akulavolk/AudioProcessor/README.md

Volume/tone control board based on the TDA7439 audio processor chip and [ahuxtable's Arduino library](https://github.com/ahuxtable/TDA7439).
