akulavolk/AudioProcessor/board/BOM.xlsx

Table 1
Qty | Value | Device | Package | Parts | Description | MPN | Notes
1 |  | DIODE-DO214AC | DO-214AC | D2 |  | MF-DIO-SMA-B140
2 | 0.1uF | CAPACITOR-0603 | CAPACITOR-0603 | C1, C5 | Ceramic Capacitor | MF-CAP-0603-0.1uF
2 | 0.47uF | CAPACITOR-5MM | CAPACITOR-5MM | C4, C7 | Film Capacitor | B32529C474J | This should be B32529C0474J289 but this is what returns an available result in MacroFab’s search
1 | 100K | RESISTOR-0805 | RESISTOR-0805 | R8 |  | MF-RES-0805-100K
4 | 100nF | CAPACITOR-5MM | CAPACITOR-5MM | C13, C14, C15, C16 | Film Capacitor | B32529C0104J289 | This should be B32529C0104J289 but we use the mangled part number so Macrofab can find the one we want
3 | 10K | RESISTOR-0805 | RESISTOR-0805 | R3, R4, R5 |  | MF-RES-0805-10K
3 | 10uF | CAPACITOR-1206 | CAPACITOR-1206 | C2, C3, C6 | Ceramic Capacitor | MF-CAP-1206-10uF
2 | 18nF | CAPACITOR-5MM | CAPACITOR-5MM | C11, C18 | Film Capacitor | B32529C0183J289 | Suffix 000 is bulk packaging
2 | 2.7K | RESISTOR-0805 | RESISTOR-0805 | R10, R11 |  | RC0805FR-072K7L
2 | 22nF | CAPACITOR-5MM | CAPACITOR-5MM | C12, C17 | Film Capacitor | B32529C0223J289 | Suffix 000 is bulk packaging
3 | 470 | RESISTOR-0805 | RESISTOR-0805 | R1, R2, R6 |  | MF-RES-0805-470
1 | 470uF | CAPACITOR-POLARIZED-3.5-8 | CAP-POL-3.5-8 | C9 | Polarized Capacitor | 16YXJ470M8X11.5
2 | 5.6K | RESISTOR-0805 | RESISTOR-0805 | R9, R12 |  | MF-RES-0805-5.6K
2 | 5.6nF | CAPACITOR-5MM | CAPACITOR-5MM | C8, C10 | Film Capacitor | B32529C0562J289 | Suffix 000 is bulk packaging
1 | 680K | RESISTOR-0805 | RESISTOR-0805 | R7 |  | MF-RES-0805-680K
1 | ATTINY24/44/84-SSU | ATTINY24/44/84-SSU | SO-14 | IC1 | 8-bit Microcontroller with In-System Programmable Flash | ATTINY84A-SSU
1 | ICSP-HEADER-6 | ICSP-HEADER-6 | ICSP-HEADER | ISP1 | ICSP HEADER
1 | LED-0805 | LED-0805 | LED-0805 | D1 |  | MF-LED-0805-RED
2 | LP2951 | LP2951 | SOIC-08 | IC2, IC3 |  | LP2951-33DR
4 | PINHD-1X3-JST-PH | PINHD-1X3-JST-PH | JST-B3B-PH | J1, J2, J3, J4 | PIN HEADER | B3B-PH-K-S(LF)(SN)
1 | PINHD-1X2-JST-PH | PINHD-1X2-JST-PH | JST-B3B-PH | J5 | PIN HEADER | B2B-PH-K-S(LF)(SN)
1 | PINHD-1X6-JST-PH | PINHD-1X6-JST-PH | JST-B6B-PH | J6 |  | B6B-PH-K-S(LF)(SN)
1 | TDA7439DS | TDA7439DS | SO-28W | IC4 |  | TDA7439DS13TR
