akulavolk/AudioProcessor/board/AudioProcessor.brd

## EAGLE design board/AudioProcessor.brd (2018-02-14)

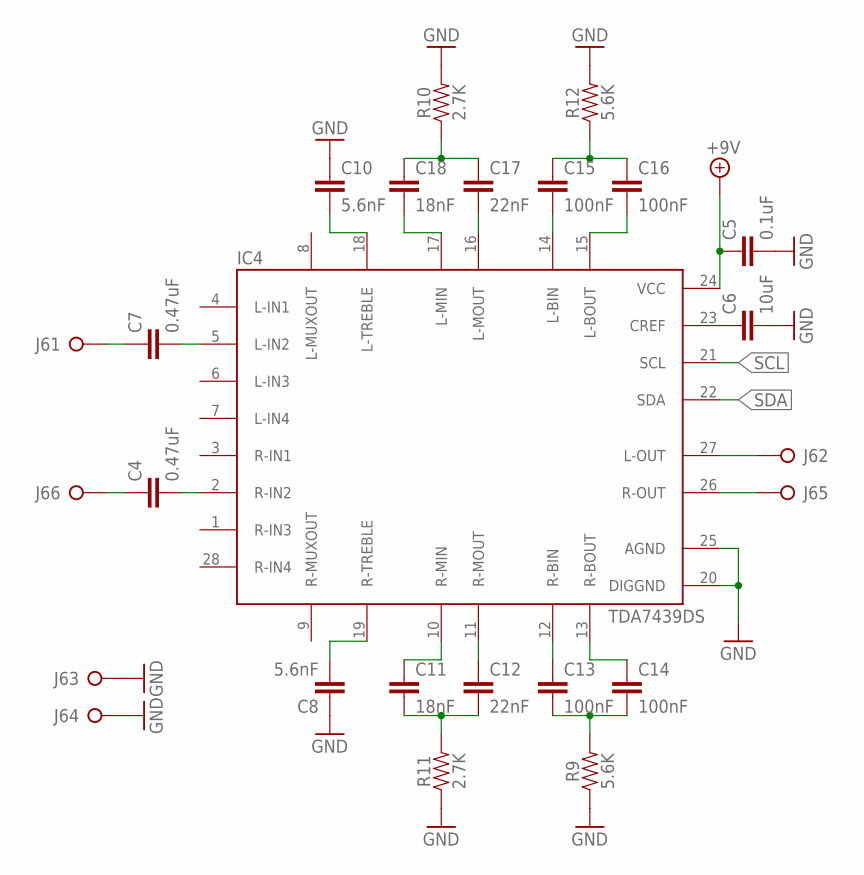
[picture p1: schematic AudioProcessor.sch, sheet 1]

Parts:
C4, C7: 0.47uF; CAPACITOR-5MM
C5: 0.1uF; CAPACITOR-0603
C6: 10uF; CAPACITOR-1206
C8, C10: 5.6nF; CAPACITOR-5MM
C11, C18: 18nF; CAPACITOR-5MM
C12, C17: 22nF; CAPACITOR-5MM
C13, C14, C15, C16: 100nF; CAPACITOR-5MM
IC4: TDA7439DS; SO-28W
J6: PINHD-1X6-JST-PH; JST-B6B-PH
R9, R12: 5.6K; RESISTOR-0805
R10, R11: 2.7K; RESISTOR-0805

Connections:
+9V: C5.1, IC4.24 (VCC); also elsewhere on the board
GND: C5.2, C6.2, C8.1, C10.1, IC4.20 (DIGGND), IC4.25 (AGND), J6.3, J6.4, R9.1, R10.2, R11.1, R12.2; also elsewhere on the board
L-IN: C7.2, IC4.5 (L-IN2)
L-IN-RAW: C7.1, J6.1
L-OUT: IC4.27 (L-OUT), J6.2
unnamed: C10.2, IC4.18 (L-TREBLE)
unnamed: C18.2, IC4.17 (L-MIN)
unnamed: C17.2, IC4.16 (L-MOUT)
unnamed: C17.1, C18.1, R10.1
unnamed: C15.2, IC4.14 (L-BIN)
unnamed: C16.2, IC4.15 (L-BOUT)
unnamed: C15.1, C16.1, R12.1
unnamed: C8.2, IC4.19 (R-TREBLE)
unnamed: C11.1, IC4.10 (R-MIN)
unnamed: C12.1, IC4.11 (R-MOUT)
unnamed: C11.2, C12.2, R11.2
unnamed: C13.2, C14.2, R9.2
unnamed: C14.1, IC4.13 (R-BOUT)
unnamed: C13.1, IC4.12 (R-BIN)
unnamed: C6.1, IC4.23 (CREF)
R-IN: C4.2, IC4.2 (R-IN2)
R-IN-RAW: C4.1, J6.6
R-OUT: IC4.26 (R-OUT), J6.5
SCL: IC4.21 (SCL); also elsewhere on the board
SDA: IC4.22 (SDA); also elsewhere on the board

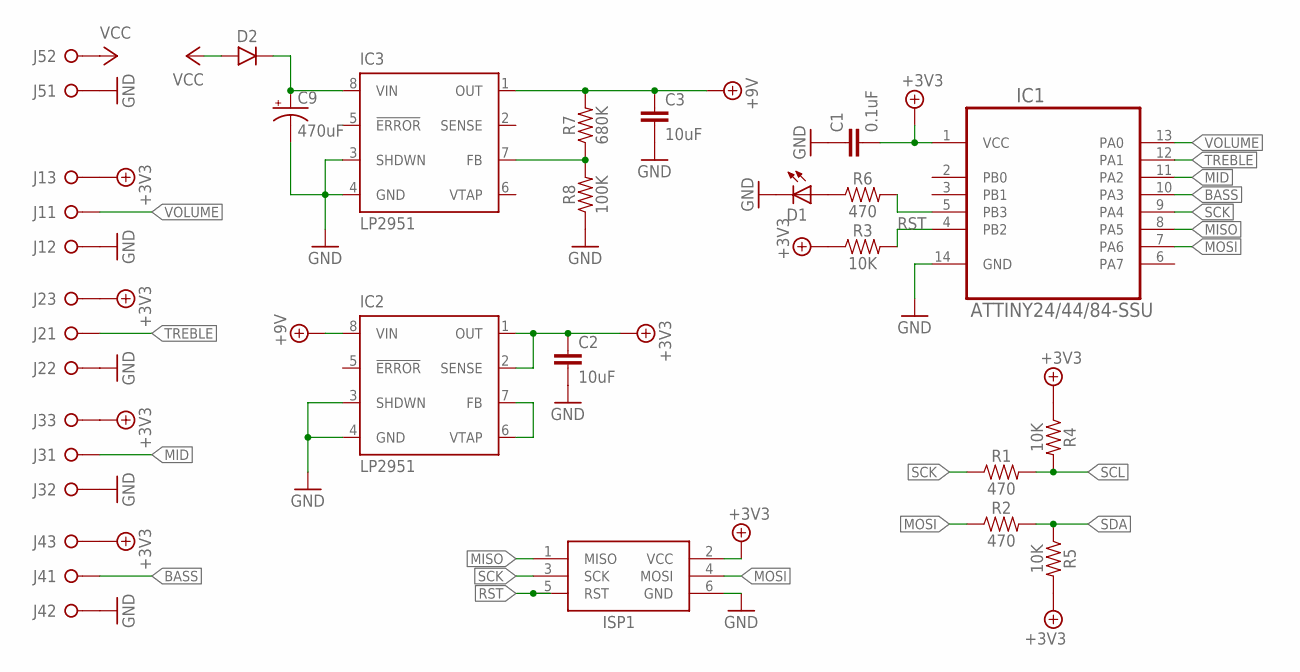
[picture p2: schematic AudioProcessor.sch, sheet 2]

Parts:
C1: 0.1uF; CAPACITOR-0603
C2, C3: 10uF; CAPACITOR-1206
C9: 470uF; CAP-POL-3.5-8
D1: LED-0805
D2: DIODE-DO214AC; DO-214AC
IC1: ATTINY24/44/84-SSU; SO-14
IC2, IC3: LP2951; SOIC-08
ISP1: ICSP-HEADER-6; ICSP-HEADER
J1, J2, J3, J4: PINHD-1X3-JST-PH; JST-B3B-PH
J5: PINHD-1X2-JST-PH; JST-B2B-PH
R1, R2, R6: 470; RESISTOR-0805
R3, R4, R5: 10K; RESISTOR-0805
R7: 680K; RESISTOR-0805
R8: 100K; RESISTOR-0805

Connections:
+3V3: C1.2, C2.1, IC1.1 (VCC), IC2.1 (OUT), IC2.2 (SENSE), ISP1.2 (VCC), J1.3, J2.3, J3.3, J4.3, R3.1, R4.1, R5.2
+9V: C3.1, IC2.8 (VIN), IC3.1 (OUT), R7.2; also elsewhere on the board
BASS: IC1.10 (PA3), J4.1
GND: C1.1, C2.2, C3.2, C9.-, D1.2 (C), IC1.14 (GND), IC2.3 (SHDWN), IC2.4 (GND), IC3.3 (SHDWN), IC3.4 (GND), ISP1.6 (GND), J1.2, J2.2, J3.2, J4.2, J5.1, R8.1; also elsewhere on the board
LED: IC1.5 (PB3), R6.2
MID: IC1.11 (PA2), J3.1
MISO: IC1.8 (PA5), ISP1.1 (MISO)
MOSI: IC1.7 (PA6), ISP1.4 (MOSI), R2.1
unnamed: D1.1 (A), R6.1
unnamed: IC3.7 (FB), R7.1, R8.2
unnamed: C9.+, D2.2 (-), IC3.8 (VIN)
unnamed: IC2.6 (VTAP), IC2.7 (FB)
RST: IC1.4 (PB2), ISP1.5 (RST), R3.2
SCK: IC1.9 (PA4), ISP1.3 (SCK), R1.1
SCL: R1.2, R4.2; also elsewhere on the board
SDA: R2.2, R5.1; also elsewhere on the board
TREBLE: IC1.12 (PA1), J2.1
VCC: D2.1 (+), J5.2
VOLUME: IC1.13 (PA0), J1.1

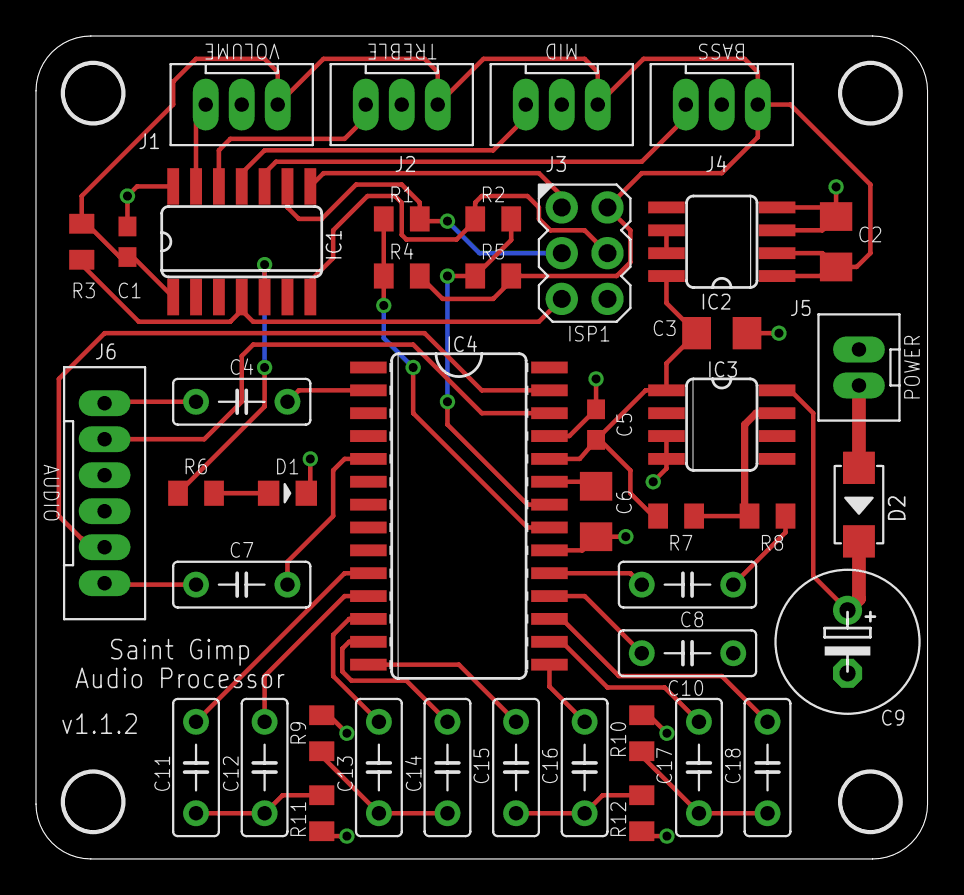
[picture p3: board AudioProcessor.brd from above]

Board: 2 copper layers, 49.5 x 45.7 mm, 47 parts (0 on the bottom side), 40 nets.

Other parts of the board:
U$1, U$2, U$3, U$4: MOUNTING-HOLE-3.2MM
