akulavolk/AudioProcessor/(commit log)

2016-11-15 Move code files because Arduino IDE is silly
2017-02-03 V1 plus a few in-progress modifications
    [AudioProcessor.brd, AudioProcessor.sch]
2017-02-03 Removed unnecessary output biasing
    [AudioProcessor.brd, AudioProcessor.sch]
2017-03-03 Add status LED and other improvements
    [AudioProcessor.brd, AudioProcessor.sch]
2017-09-09 Change regulator programming resistor to a value that matches house part availability and still gives us an acceptable output voltage.
    [AudioProcessor.brd, AudioProcessor.sch]
2017-10-25 Update with library changes and tune for Macrofab house parts
    [AudioProcessor.brd, AudioProcessor.sch]
2017-10-25 Add BOM document
    [BOM.xlsx]
2017-10-26 Move silkscreen text to the correct layers, and update BOM
    [AudioProcessor.brd, BOM.xlsx]
2017-10-27 Fix JST header orientation
    [AudioProcessor.brd, AudioProcessor.sch]
2018-02-14 Board updates for manufacturing
    [AudioProcessor.brd, AudioProcessor.sch, BOM.xlsx]
2018-02-14 Avoid headaches when flashing an operating system
    [AudioProcessor.ino]
